dodgymike/dc26-monero-badge-pcb/monero-coin-with-ears.png

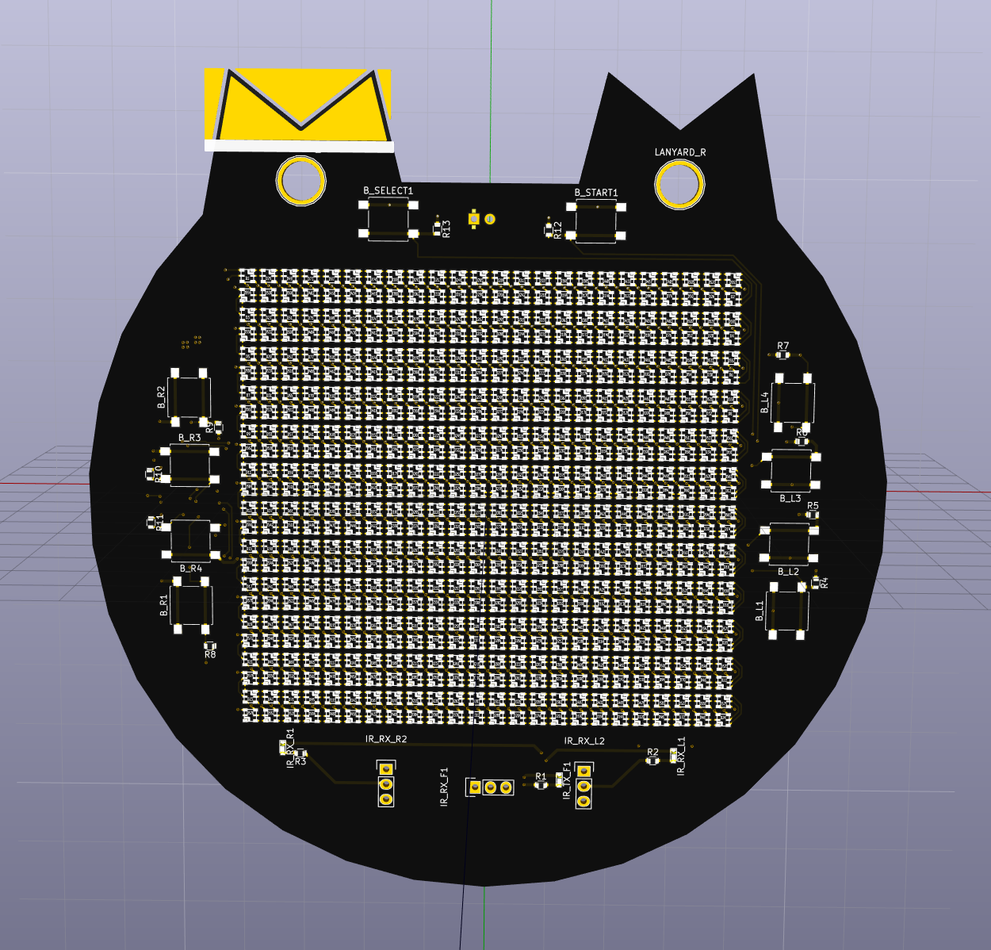
monero-coin-with-ears.png
