dodgymike/dc26-monero-badge-pcb/README.md

# Monero DC26 PCB kicad project
This repo contains the kicad project for the Monero Unofficial Defcon 26 badge

# Firmware
The firmware for this badge can be found [here](https://github.com/dodgymike/monero-badge-f405)

# Youtube
* An animation of the PCB design process over time can be found [here](https://www.youtube.com/watch?v=O-3lbjU6kjA)

# Challenge coins
The DC26 challenge coin PCB project is in the dc26-challenge directory
