dodgymike/dc26-monero-badge-pcb/coin-circle-center.png

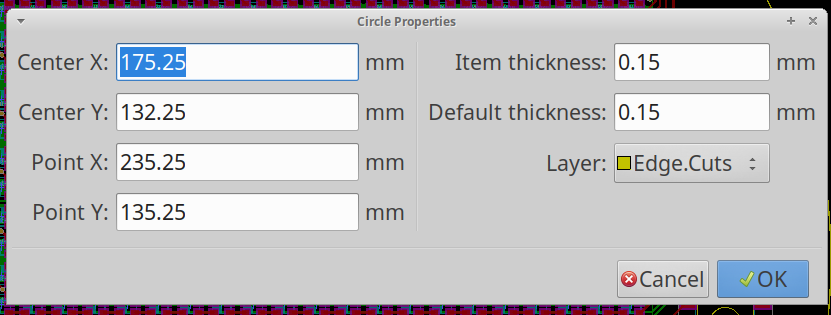
coin-circle-center.png
