dodgymike/dc26-monero-badge-pcb/kicad-panda.png

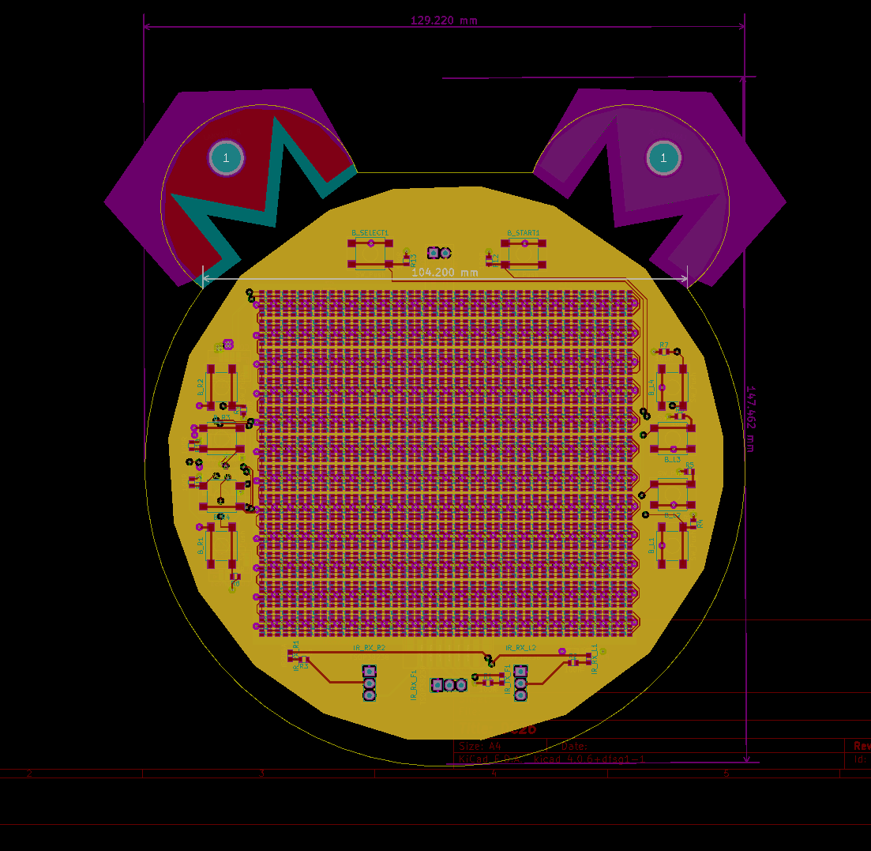
kicad-panda.png
