dodgymike/dc26-monero-badge-pcb/wide-panda-ears.png

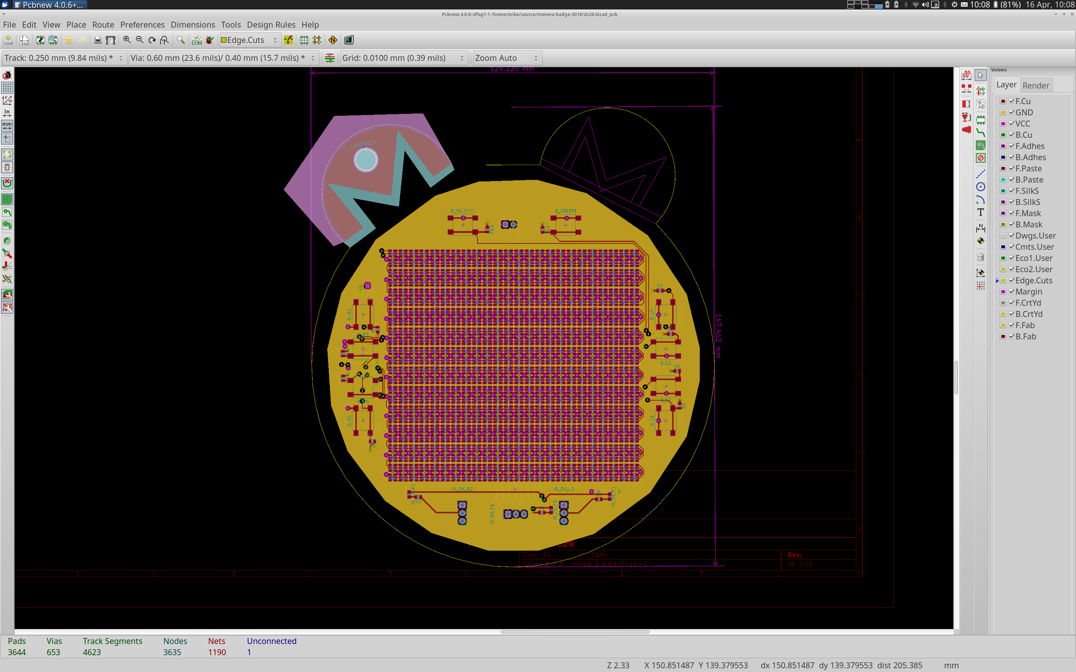
wide-panda-ears.png
