dodgymike/dc26-monero-badge-pcb/dc26.csv

Reference | Value | Footprint | Datasheet
B_SHIFT_2 | 74LS165 | Housings_SSOP:TSSOP-16_4.4x5mm_Pitch0.65mm
B_L1 | SW_Push | Buttons_Switches_SMD:SW_SPST_EVQQ2
B_L2 | SW_Push | Buttons_Switches_SMD:SW_SPST_EVQQ2
B_L3 | SW_Push | Buttons_Switches_SMD:SW_SPST_EVQQ2
B_L4 | SW_Push | Buttons_Switches_SMD:SW_SPST_EVQQ2
B_R1 | SW_Push | Buttons_Switches_SMD:SW_SPST_EVQQ2
B_R2 | SW_Push | Buttons_Switches_SMD:SW_SPST_EVQQ2
B_R3 | SW_Push | Buttons_Switches_SMD:SW_SPST_EVQQ2
B_R4 | SW_Push | Buttons_Switches_SMD:SW_SPST_EVQQ2
B_START1 | SW_Push | Buttons_Switches_SMD:SW_SPST_EVQQ2
B_SELECT1 | SW_Push | Buttons_Switches_SMD:SW_SPST_EVQQ2
R4 | 10k | Resistors_SMD:R_0603
R5 | 10k | Resistors_SMD:R_0603
R6 | 10k | Resistors_SMD:R_0603
R7 | 10k | Resistors_SMD:R_0603
R8 | 10k | Resistors_SMD:R_0603
R9 | 10k | Resistors_SMD:R_0603
R10 | 10k | Resistors_SMD:R_0603
R11 | 10k | Resistors_SMD:R_0603
R12 | 10k | Resistors_SMD:R_0603
R13 | 10k | Resistors_SMD:R_0603
STM32F405 | STM32F405RGTx | Housings_QFP:LQFP-64_10x10mm_Pitch0.5mm
C25 | 22pF | Capacitors_SMD:C_0603
C24 | 22pF | Capacitors_SMD:C_0603
C27 | 2u2 | Capacitors_SMD:C_0805
C26 | 2u2 | Capacitors_SMD:C_0805
C31 | 0.1pF | Capacitors_SMD:C_0603
C30 | 0.1pF | Capacitors_SMD:C_0603
C28 | 0.1pF | Capacitors_SMD:C_0603
C29 | 0.1pF | Capacitors_SMD:C_0603
R15 | 10k | Resistors_SMD:R_0603
SW_RESET1 | SW_SPST | Buttons_Switches_SMD:SW_SPST_EVQPE1
R14 | 10k | Resistors_SMD:R_0603
SW_BOOT0 | SW_SPST | Buttons_Switches_SMD:SW_SPST_EVQPE1
SWDCLK1 | PGM-SWDCLK | Measurement_Points:Measurement_Point_Round-SMD-Pad_Small
SWDIO1 | PGM-SWDIO | Measurement_Points:Measurement_Point_Round-SMD-Pad_Small
PGND1 | PGM-GND | Measurement_Points:Measurement_Point_Round-SMD-Pad_Small
NRST1 | NRST | Measurement_Points:Measurement_Point_Round-SMD-Pad_Small
BT0 | BOOT0 | Measurement_Points:Measurement_Point_Round-SMD-Pad_Small
C32 | 0.1pF | Capacitors_SMD:C_0603
BLD1 | BTN-LD | Measurement_Points:Measurement_Point_Round-SMD-Pad_Small
BCLK1 | BTN-CLK | Measurement_Points:Measurement_Point_Round-SMD-Pad_Small
BDATA1 | BTN-DATA | Measurement_Points:Measurement_Point_Round-SMD-Pad_Small
BGND2 | BTN-GND | Measurement_Points:Measurement_Point_Round-SMD-Pad_Small
Y1 | Crystal | Crystals:Crystal_SMD_5032-2pin_5.0x3.2mm
B_SHIFT_1 | 74LS165 | Housings_SSOP:TSSOP-16_4.4x5mm_Pitch0.65mm
PC0 | PC0 | Measurement_Points:Measurement_Point_Round-SMD-Pad_Small
PC1 | PC1 | Measurement_Points:Measurement_Point_Round-SMD-Pad_Small
PC2 | PC2 | Measurement_Points:Measurement_Point_Round-SMD-Pad_Small
PC3 | PC3 | Measurement_Points:Measurement_Point_Round-SMD-Pad_Small
PC4 | PC4 | Measurement_Points:Measurement_Point_Round-SMD-Pad_Small
PC5 | PC5 | Measurement_Points:Measurement_Point_Round-SMD-Pad_Small
PC6 | PC6 | Measurement_Points:Measurement_Point_Round-SMD-Pad_Small
PC7 | PC7 | Measurement_Points:Measurement_Point_Round-SMD-Pad_Small
PC8 | PC8 | Measurement_Points:Measurement_Point_Round-SMD-Pad_Small
IRTXF1 | IRTXF | Measurement_Points:Measurement_Point_Round-SMD-Pad_Small
IRRXF1 | IRRXF | Measurement_Points:Measurement_Point_Round-SMD-Pad_Small
VBAT-DIV1 | 5k-10k | TO_SOT_Packages_SMD:SOT-23
C2 | 0.1uF | Capacitors_SMD:C_0603
BATT-BUCK1 | LM2596S-5 | TO_SOT_Packages_SMD:TO-263-5_TabPin3
SW_PWRON1 | SW_SPST | Buttons_Switches_SMD:SW_SPST_EVQPE1
BATT-BUCK-INDUC1 | 44uH | DR74-330-R:INDM7676X435N
BATT-BUCK-COUT1 | 220uF | Capacitors_SMD:CP_Elec_10x10.5
BATT-BUCK-CIN1 | 100uF | Capacitors_SMD:CP_Elec_10x10.5
BATT-BUCK-PULLUP1 | 10k | Resistors_SMD:R_0603
JBBEN1 | BUCK-EN | Connect:GS2
BBEN1 | BUCK-EN | Measurement_Points:Measurement_Point_Round-SMD-Pad_Small
BIN1 | BT-IN | Measurement_Points:Measurement_Point_Round-SMD-Pad_Small
BGND1 | BT-GND | Measurement_Points:Measurement_Point_Round-SMD-Pad_Small
REG_3V3 | TC1262-33VDB | TO_SOT_Packages_SMD:SOT-223
R17 | 470R | Resistors_SMD:R_0603
PWR_3V3 | LED | LEDs:LED_0603
C33 | 4u7 | Capacitors_SMD:C_0603
C34 | 4u7 | Capacitors_SMD:C_0603
BATT-BUCK-SCHOTT1 | D_Schottky | digikey-footprints:DO-214AB
R20 | 470R | Resistors_SMD:R_0603
PWR_5V1 | LED | LEDs:LED_0603
MPU6000 | MPU-6000 | Housings_DFN_QFN:QFN-24_4x4mm_Pitch0.5mm
C37 | 0.1uF | Capacitors_SMD:C_0603
C38 | 10nF | Capacitors_SMD:C_0603
C36 | 10nF | Capacitors_SMD:C_0603
MCS1 | M-CS | Measurement_Points:Measurement_Point_Round-SMD-Pad_Small
MSCLK1 | M-SCLK | Measurement_Points:Measurement_Point_Round-SMD-Pad_Small
MMISO1 | M-MISO | Measurement_Points:Measurement_Point_Round-SMD-Pad_Small
MMOSI1 | M-MOSI | Measurement_Points:Measurement_Point_Round-SMD-Pad_Small
MINT1 | M-INT1 | Measurement_Points:Measurement_Point_Round-SMD-Pad_Small
F405_USB1 | USB_OTG | digikey-footprints:USB_Micro_B_Female_10118192
R18 | 22 | Resistors_SMD:R_0603
R19 | 22 | Resistors_SMD:R_0603
C35 | 4U7 | Capacitors_Tantalum_SMD:CP_Tantalum_Case-A_EIA-3216-18_Reflow
UID1 | USB-ID | Measurement_Points:Measurement_Point_Round-SMD-Pad_Small
JUID1 | USB-ID | Connect:GS2
JUVCC1 | USB-VCC | Connect:GS2
D1 | APA102 | gsg-modules:APA102-2020
D25 | APA102 | gsg-modules:APA102-2020
D49 | APA102 | gsg-modules:APA102-2020
D73 | APA102 | gsg-modules:APA102-2020
D97 | APA102 | gsg-modules:APA102-2020
D121 | APA102 | gsg-modules:APA102-2020
D145 | APA102 | gsg-modules:APA102-2020
D169 | APA102 | gsg-modules:APA102-2020
D193 | APA102 | gsg-modules:APA102-2020
D217 | APA102 | gsg-modules:APA102-2020
D241 | APA102 | gsg-modules:APA102-2020
D265 | APA102 | gsg-modules:APA102-2020
D289 | APA102 | gsg-modules:APA102-2020
D313 | APA102 | gsg-modules:APA102-2020
D337 | APA102 | gsg-modules:APA102-2020
D361 | APA102 | gsg-modules:APA102-2020
D385 | APA102 | gsg-modules:APA102-2020
D409 | APA102 | gsg-modules:APA102-2020
D433 | APA102 | gsg-modules:APA102-2020
D457 | APA102 | gsg-modules:APA102-2020
D481 | APA102 | gsg-modules:APA102-2020
D505 | APA102 | gsg-modules:APA102-2020
D529 | APA102 | gsg-modules:APA102-2020
D553 | APA102 | gsg-modules:APA102-2020
D2 | APA102 | gsg-modules:APA102-2020
D26 | APA102 | gsg-modules:APA102-2020
D50 | APA102 | gsg-modules:APA102-2020
D74 | APA102 | gsg-modules:APA102-2020
D98 | APA102 | gsg-modules:APA102-2020
D122 | APA102 | gsg-modules:APA102-2020
D146 | APA102 | gsg-modules:APA102-2020
D170 | APA102 | gsg-modules:APA102-2020
D194 | APA102 | gsg-modules:APA102-2020
D218 | APA102 | gsg-modules:APA102-2020
D242 | APA102 | gsg-modules:APA102-2020
D266 | APA102 | gsg-modules:APA102-2020
D290 | APA102 | gsg-modules:APA102-2020
D314 | APA102 | gsg-modules:APA102-2020
D338 | APA102 | gsg-modules:APA102-2020
D362 | APA102 | gsg-modules:APA102-2020
D386 | APA102 | gsg-modules:APA102-2020
D410 | APA102 | gsg-modules:APA102-2020
D434 | APA102 | gsg-modules:APA102-2020
D458 | APA102 | gsg-modules:APA102-2020
D482 | APA102 | gsg-modules:APA102-2020
D506 | APA102 | gsg-modules:APA102-2020
D530 | APA102 | gsg-modules:APA102-2020
D554 | APA102 | gsg-modules:APA102-2020
D3 | APA102 | gsg-modules:APA102-2020
D27 | APA102 | gsg-modules:APA102-2020
D51 | APA102 | gsg-modules:APA102-2020
D75 | APA102 | gsg-modules:APA102-2020
D99 | APA102 | gsg-modules:APA102-2020
D123 | APA102 | gsg-modules:APA102-2020
D147 | APA102 | gsg-modules:APA102-2020
D171 | APA102 | gsg-modules:APA102-2020
D195 | APA102 | gsg-modules:APA102-2020
D219 | APA102 | gsg-modules:APA102-2020
D243 | APA102 | gsg-modules:APA102-2020
D267 | APA102 | gsg-modules:APA102-2020
D291 | APA102 | gsg-modules:APA102-2020
D315 | APA102 | gsg-modules:APA102-2020
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
D383 | APA102 | gsg-modules:APA102-2020
D407 | APA102 | gsg-modules:APA102-2020
D431 | APA102 | gsg-modules:APA102-2020
D455 | APA102 | gsg-modules:APA102-2020
D479 | APA102 | gsg-modules:APA102-2020
D503 | APA102 | gsg-modules:APA102-2020
D527 | APA102 | gsg-modules:APA102-2020
D551 | APA102 | gsg-modules:APA102-2020
D575 | APA102 | gsg-modules:APA102-2020
D24 | APA102 | gsg-modules:APA102-2020
D48 | APA102 | gsg-modules:APA102-2020
D72 | APA102 | gsg-modules:APA102-2020
D96 | APA102 | gsg-modules:APA102-2020
D120 | APA102 | gsg-modules:APA102-2020
D144 | APA102 | gsg-modules:APA102-2020
D168 | APA102 | gsg-modules:APA102-2020
D192 | APA102 | gsg-modules:APA102-2020
D216 | APA102 | gsg-modules:APA102-2020
D240 | APA102 | gsg-modules:APA102-2020
D264 | APA102 | gsg-modules:APA102-2020
D288 | APA102 | gsg-modules:APA102-2020
D312 | APA102 | gsg-modules:APA102-2020
D336 | APA102 | gsg-modules:APA102-2020
D360 | APA102 | gsg-modules:APA102-2020
D384 | APA102 | gsg-modules:APA102-2020
D408 | APA102 | gsg-modules:APA102-2020
D432 | APA102 | gsg-modules:APA102-2020
D456 | APA102 | gsg-modules:APA102-2020
D480 | APA102 | gsg-modules:APA102-2020
D504 | APA102 | gsg-modules:APA102-2020
D528 | APA102 | gsg-modules:APA102-2020
D552 | APA102 | gsg-modules:APA102-2020
D576 | APA102 | gsg-modules:APA102-2020
C1 | 1uF | Capacitors_SMD:C_0603
C4 | 1uF | Capacitors_SMD:C_0603
C9 | 1uF | Capacitors_SMD:C_0603
C12 | 1uF | Capacitors_SMD:C_0603
C13 | 1uF | Capacitors_SMD:C_0603
C14 | 1uF | Capacitors_SMD:C_0603
C20 | 1uF | Capacitors_SMD:C_0603
C22 | 1uF | Capacitors_SMD:C_0603
LCKI1 | LED-CKI | Measurement_Points:Measurement_Point_Round-SMD-Pad_Small
LSDI1 | LED-SDI | Measurement_Points:Measurement_Point_Round-SMD-Pad_Small
LGND1 | LED-GND | Measurement_Points:Measurement_Point_Round-SMD-Pad_Small
LVCC1 | LED-VCC | Measurement_Points:Measurement_Point_Round-SMD-Pad_Small
LEN1 | LED-EN | Measurement_Points:Measurement_Point_Round-SMD-Pad_Small
Q1 | IRLB8721PBF | TO_SOT_Packages_SMD:SOT-223-3_TabPin2
R21 | 10k | Resistors_SMD:R_0603
JLPWR1 | LED-PWR | Connect:GS2
JLEN1 | LED-EN | Connect:GS2
R22 | 470R | Resistors_SMD:R_0603
PWR_DISPLAY1 | LED | LEDs:LED_0603
BATT-B-FUSE1 | Polyfuse | Fuse:Fuse_1812_4532Metric
BATT-A-FUSE1 | Polyfuse | Fuse:Fuse_1812_4532Metric
BATT-B1 | 18650 | Battery_Holders:Keystone_1042_1x18650
BATT-A1 | 18650 | Battery_Holders:Keystone_1042_1x18650
PWR_BATT1 | LED | LEDs:LED_0603
R16 | 470R | Resistors_SMD:R_0603
IR_TX_F1 | IR204A | custom-footprints:OSRAM-Midled
IR_RX_L2 | IR204A | custom-footprints:OSRAM-Midled
IR_RX_R2 | IR204A | custom-footprints:OSRAM-Midled
R1 | 100R | Resistors_SMD:R_0603
R3 | 100R | Resistors_SMD:R_0603
R2 | 100R | Resistors_SMD:R_0603
R23 | 100 | Resistors_SMD:R_0603
R24 | 100 | Resistors_SMD:R_0603
R25 | 100 | Resistors_SMD:R_0603
IR-F1 | TSOP77 | tsop77:SOIC-4
IR-L1 | TSOP77 | tsop77:SOIC-4
IR-R1 | TSOP77 | tsop77:SOIC-4
C6 | 0.1uF | Capacitors_SMD:C_0603
C5 | 0.1uF | Capacitors_SMD:C_0603
C3 | 0.1uF | Capacitors_SMD:C_0603
IR_RX_L1 | IR204A | custom-footprints:OSRAM-Midled
IR_TX_F2 | IR204A | custom-footprints:OSRAM-Midled
IR_RX_R1 | IR204A | custom-footprints:OSRAM-Midled
