dodgymike/dc26-monero-badge-pcb/dc26-challenge/#coin-code-2.dxf-r12.dxf

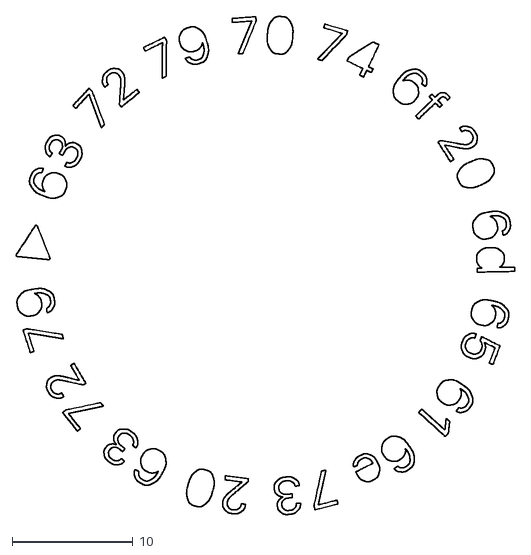
[picture p5: CAD file, 2018-07-02]
dc26-challenge/#coin-code-2.dxf-r12.dxf
41.3 x 41.2
