dodgymike/dc26-monero-badge-pcb/dc26-challenge/coin-code.dxf-r12.dxf

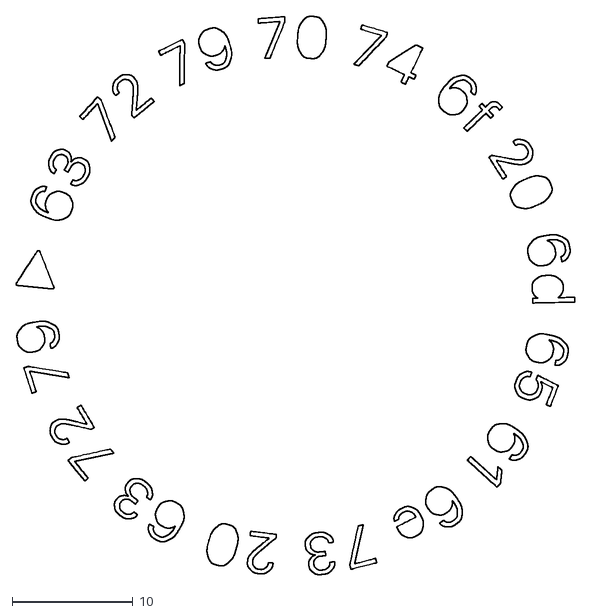
[picture p6: CAD file, 2018-07-02]
dc26-challenge/coin-code.dxf-r12.dxf
46.3 x 46.3
