dodgymike/dc26-monero-badge-pcb/dc26-challenge/mike02.dxf

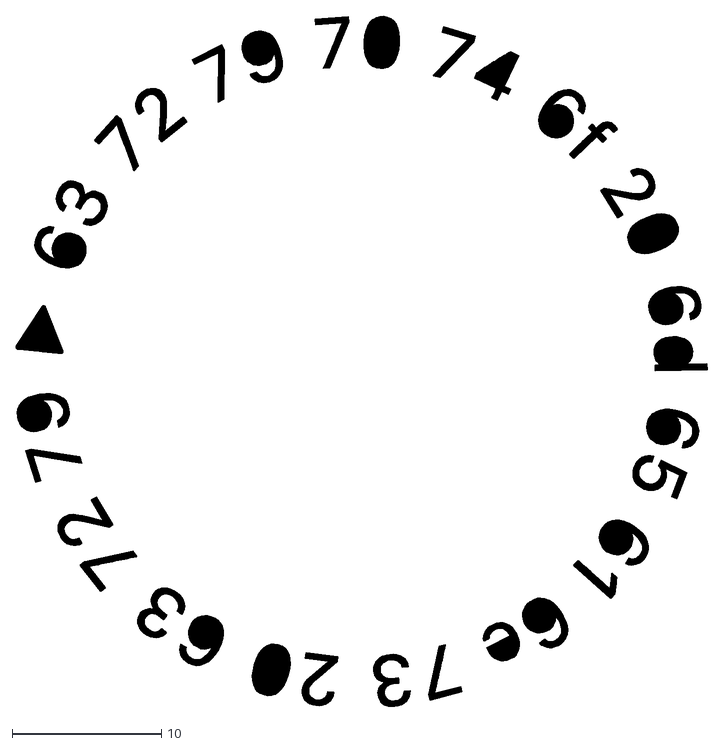
[picture p7: CAD file, 2018-07-02]
dc26-challenge/mike02.dxf
46.3 x 46.3
