dodgymike/dc26-monero-badge-pcb/(list of files, cad)

Other CAD files:
monero_m.dxf
dc26-challenge/mike03.dwg
dc26-challenge/mike05.dxf
dc26-challenge/mike01.dxf
dc26-challenge/mike04.dxf
dc26-challenge/coin-code-2.dxf-r12.dxf
