dodgymike/dc26-monero-badge-pcb/(commit log)

2018-04-01 Initial import
    [dc26.kicad_pcb, dc26.sch, inverted-leds.kicad_pcb]
2018-04-01 Finished with LED connections
    [dc26.kicad_pcb]
2018-04-12 Added IR/buttons/etc
    [_saved_dc26.sch, dc26.kicad_pcb, dc26.sch]
2018-04-14 Coin badge almost layed out
    [_saved_dc26.sch, dc26.kicad_pcb, dc26.sch]
2018-04-14 Prototype board layout complete
    [dc26.kicad_pcb]
2018-04-15 Final coin version
    [dc26-M.kicad_pcb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]
2018-04-16 Panda ears + images
    [dc26.kicad_pcb]
2018-04-16 Prototype complete
    [dc26.kicad_pcb, dc26.sch]
2018-04-16 Move a resistor out of the way of the led plug
    [dc26.kicad_pcb]
2018-04-17 front/back fills
    [dc26.kicad_pcb]
2018-04-17 Fix IR rx orientation
    [dc26.kicad_pcb]
2018-04-17 Little tweak
    [dc26.kicad_pcb]
2018-04-17 Extended and fixed top fill layer
    [dc26.kicad_pcb]
2018-05-22 gerbers + flipped leds + start of on-board stm32f405
    [dc26.csv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]
2018-05-24 finished led flipping
    [dc26.kicad_pcb]
2018-05-26 Top cutout + mpu6000 + spi connections
    [_saved_dc26.sch]
2018-05-26 moved ICs to top left and connected pins
    [_saved_dc26.sch, dc26.kicad_pcb, dc26.sch]
2018-05-26 More work on f405
    [dc26.kicad_pcb, dc26.sch]
2018-05-30 F405 schematic almost done
    [dc26.sch]
2018-05-30 mpu6000 circuit complete + power circuit extracted + other changes
    [USB.sch, batteries.sch, dc26.sch, mpu6000.sch, power-converter.sch]
2018-05-30 Moved LEDs to new sheet
    [USB.sch, batteries.sch, dc26.sch, mpu6000.sch, power-converter.sch, rgb-leds.sch]
2018-05-30 zone movement + routing of all circuits
    [USB.sch, _saved_dc26.sch, batteries.sch, mpu6000.sch, power-converter.sch, rgb-leds.sch]
2018-05-31 splitting led power out from 5v so that we can insert the mosfet
    [USB.sch, _saved_dc26.sch, batteries.sch, dc26.sch, mpu6000.sch, power-converter.sch, rgb-leds.sch]
2018-05-31 Footprint updates
    [USB.sch, batteries.sch, dc26.sch, power-converter.sch, rgb-leds.sch]
2018-05-31 Add leds for the three power planes
    [power-converter.sch, rgb-leds.sch]
2018-05-31 Futher cleanup and footprint work, as well as power circuit fixes
    [USB.sch, batteries.sch, dc26.kicad_pcb, dc26.sch, mpu6000.sch, power-converter.sch, rgb-leds.sch]
2018-05-31 Further updates
    [USB.sch, batteries.sch, dc26.kicad_pcb, dc26.sch, mpu6000.sch, power-converter.sch, rgb-leds.sch]
2018-05-31 Power leds
    [USB.sch, batteries.sch, dc26.kicad_pcb, dc26.sch, mpu6000.sch, power-converter.sch, rgb-leds.sch]
2018-05-31 pcb layout
    [dc26.kicad_pcb, mpu6000.sch, power-converter.sch]
2018-06-01 all components apart from caps and two tps placed
    [dc26.kicad_pcb]
2018-06-01 No unconnected pads left
    [_saved_rgb-leds.sch, dc26.kicad_pcb]
2018-06-01 Changing tp silkscreen names
    [IR.sch, USB.sch, _saved_rgb-leds.sch, batteries.sch, dc26.sch, mpu6000.sch, power-converter.sch, rgb-leds.sch]
2018-06-01 tp name fixes
    [USB.sch, dc26.sch, mpu6000.sch, power-converter.sch, rgb-leds.sch]
2018-06-01 Name changes on silk
    [IR.sch, USB.sch, batteries.sch, dc26.kicad_pcb, dc26.sch, mpu6000.sch, power-converter.sch, rgb-leds.sch]
2018-06-02 Pads for unused pins
    [IR.sch, USB.sch, batteries.sch, dc26.kicad_pcb, dc26.sch, mpu6000.sch, power-converter.sch, rgb-leds.sch]
2018-06-02 All connected apart from IR
    [_saved_dc26.sch, dc26.kicad_pcb]
2018-06-03 Crypto AF
    [dc26.kicad_pcb]
2018-06-04 voltage divider
    [_saved_dc26.sch, dc26.kicad_pcb, dc26.sch]
2018-06-05 Fixed up some mess + IR + USB new footprint + buttons
    [IR.sch, USB.sch, batteries.sch, dc26.kicad_pcb, dc26.sch, mpu6000.sch, power-converter.sch, rgb-leds.sch]
2018-06-06 clean up and moved shifters to 3.3v
    [dc26.kicad_pcb, dc26.sch]
2018-06-06 All connected, fixing DRC problems
    [dc26.kicad_pcb]
2018-06-06 DRC corrections
    [dc26.kicad_pcb]
2018-06-06 Changed MPU6000 footprint to one without the die pad
    [dc26.kicad_pcb, mpu6000.sch]
2018-06-06 IR fixes + routing fixes
    [IR.sch, USB.sch, batteries.sch, dc26.kicad_pcb, dc26.sch, mpu6000.sch, power-converter.sch, rgb-leds.sch]
2018-06-06 Fixed tracks traversing battery holder holes
    [dc26.kicad_pcb]
2018-06-06 Final missing track fixed
    [dc26.kicad_pcb]
2018-06-07 Fixed track outside edge cuts for IR
    [dc26-B.Cu.gbl, dc26-B.Mask.gbs, dc26-B.SilkS.gbo, dc26-Edge.Cuts.gm1, dc26-F.Cu.gtl, dc26-F.Mask.gts, dc26-F.SilkS.gto, dc26.drl]
2018-06-07 Fixed truncated track (sitting outside of edge cut)
    [dc26-B.Cu.gbl, dc26-B.Mask.gbs, dc26-B.SilkS.gbo, dc26-Edge.Cuts.gm1, dc26-F.Cu.gtl, dc26-F.Mask.gts, dc26-F.SilkS.gto, dc26.drl]
2018-06-08 Add keepout zones along edge cuts
    [dc26.kicad_pcb]
2018-06-08 Fixes for slots, battery holder moved back off the MPU6000 and tracks re-routed
    [dc26.kicad_pcb]
2018-06-08 Fixes for solder mask etc + 'A' test under button for challenge coins
    [dc26.kicad_pcb]
2018-06-08 Better noise control of power converter circuit
    [dc26.kicad_pcb]
2018-06-08 More zones for 5v under power converter
    [dc26.kicad_pcb]
2018-06-08 Updated git sha text
    [dc26.kicad_pcb]
2018-06-08 Updated Gerbers
    [dc26-B.Cu.gbl, dc26-B.Mask.gbs, dc26-B.SilkS.gbo, dc26-Edge.Cuts.gm1, dc26-F.Cu.gtl, dc26-F.Mask.gts, dc26-F.SilkS.gto, dc26.drl]
2018-06-21 Added board plotter
2018-07-02 Challenge coins started
    [#coin-code-2.dxf-r12.dxf, coin-code-2.dxf-r12.dxf, coin-code.dxf-r12.dxf, dc26-challenge.kicad_pcb, dc26-challenge.sch, dc26.kicad_pcb, mike01.dxf, mike02.dxf]
2018-07-02 Icons for challenge coins
    [dc26-challenge.kicad_pcb]
2018-07-02 Fixed key
    [dc26-challenge.kicad_pcb]
2018-07-02 Challenge coin icons almost complete
    [#coin-code-2.dxf-r12.dxf, dc26-challenge.kicad_pcb]
2018-07-02 Final icons + ciphertext
    [dc26-challenge.kicad_pcb]
2018-07-02 More fixes for challenge coins
    [dc26-challenge.kicad_pcb]
2018-07-02 Fix Gerber errors
    [dc26-challenge-B.Cu.gbl, dc26-challenge-B.Mask.gbs, dc26-challenge-B.SilkS.gbo, dc26-challenge-Edge.Cuts.gm1, dc26-challenge-F.Cu.gtl, dc26-challenge-F.Mask.gts, dc26-challenge-F.SilkS.gto, dc26-challenge.drl]
2018-07-02 latest gerbers for challenge coin
    [dc26-challenge-B.Cu.gbl, dc26-challenge-B.Mask.gbs, dc26-challenge-B.SilkS.gbo, dc26-challenge-Edge.Cuts.gm1, dc26-challenge-F.Cu.gtl, dc26-challenge-F.Mask.gts, dc26-challenge-F.SilkS.gto, dc26-challenge.drl]
2018-07-02 NPTH drill holes for snaps
    [dc26-challenge-B.Cu.gbl, dc26-challenge-B.Mask.gbs, dc26-challenge-B.SilkS.gbo, dc26-challenge-Edge.Cuts.gm1, dc26-challenge-F.Cu.gtl, dc26-challenge-F.Mask.gts, dc26-challenge-F.SilkS.gto, dc26-challenge.drl]
2018-07-03 Fixed bad crypto
    [dc26-challenge.kicad_pcb]
2018-08-13 challenge coin
    [dc26-challenge-B.Cu.gbl, dc26-challenge-B.Mask.gbs, dc26-challenge-B.SilkS.gbo, dc26-challenge-Edge.Cuts.gm1, dc26-challenge-F.Cu.gtl, dc26-challenge-F.Mask.gts, dc26-challenge-F.SilkS.gto, dc26-challenge.drl]
